srividyaprasad/DroneThrustBenchSoftware/README.md

# DroneThrustBenchSoftware
"Software - DAQ and Motor Control with UI" folder contains the software.
