srividyaprasad/DroneThrustBenchSoftware/Lit Survey for Fault Detection with Data Acquired.docx

- Machine Learning for UAV Propeller Fault Detection based on a Hybrid Data Generation Model https://arxiv.org/ftp/arxiv/papers/2302/2302.01556.pdf
- Remaining Useful Battery Life Prediction for UAVs based on Machine Learning https://www.diva-portal.org/smash/get/diva2:1150694/FU
- Weak Degradation Characteristics Analysis of UAV Motors Based on Laplacian Eigenmaps and Variational Mode Decomposition https://www.ncbi.nlm.nih.gov/pmc/articles/PMC6387021/
- https://www.sciencedirect.com/science/article/pii/S1270963822005958
