srividyaprasad/DroneThrustBenchSoftware/Individual Sensor Codes for Debugging and Testing/calib_measure_loadcell/calib_measure_loadcell.ino

#include "HX711.h"

// HX711 circuit wiring
const int LOADCELL_DOUT_PIN = 2;
const int LOADCELL_SCK_PIN = 3;

HX711 scale;

void setup() {
  Serial.begin(115200);
  scale.begin(LOADCELL_DOUT_PIN, LOADCELL_SCK_PIN);
  Serial.println("Enter your choice:\n0: Calibration \n1:Measure weight");
}

void calib() {
  if (scale.is_ready()) {
    scale.set_scale();    
    Serial.println("Tare... remove any weights from the scale.");
    delay(5000);
    scale.tare();
    Serial.println("Tare done...");
    Serial.print("Place a known weight on the scale...");
    delay(5000);
    long reading = scale.get_units(10);
    Serial.print("Result: ");
    Serial.println(reading);
  } 
  else {
    Serial.println("HX711 not found.");
  }
  delay(1000);
}
void measure()
{
    Serial.print("Place weight to be measured on the scale...");
    delay(5000);
    long reading = scale.get_units(10);
    Serial.print("Result: ");
    Serial.println(reading);
}
void loop()
{
  if (Serial.available())
  {
  int choice=Serial.read();
  switch(choice)
  {
    case 48: calib(); //Enter 0 for calibrate
    break;
    case 49: measure(); //Enter 1 to measure
    break;
    }
  }
}
